Fluorescence-dxf/Gen-AI-Powered-Monitoring-System/Capstone/Dokumentasi/Team1.png

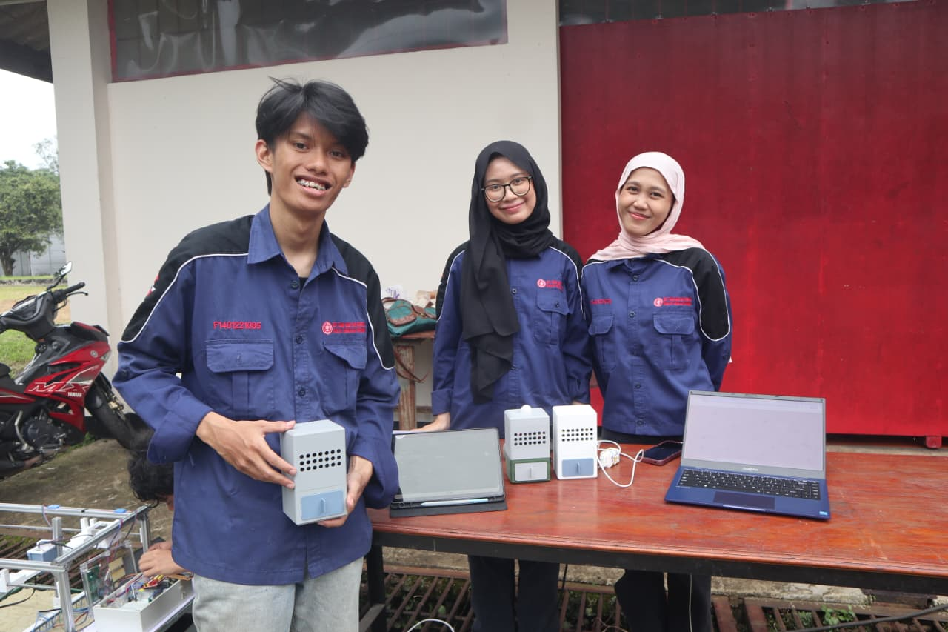
Capstone/Dokumentasi/Team1.png
