Fluorescence-dxf/Gen-AI-Powered-Monitoring-System/Capstone/Dokumentasi/Team.png

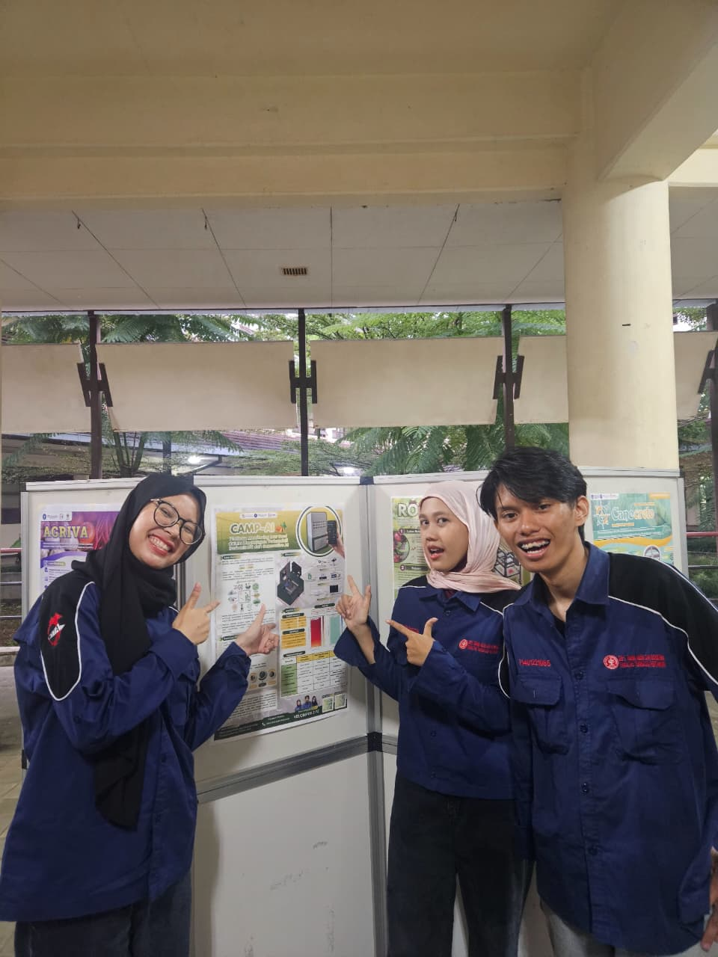
Capstone/Dokumentasi/Team.png
