Fluorescence-dxf/Gen-AI-Powered-Monitoring-System/Capstone/Desain/Bagian Bawah_Capstone.stl

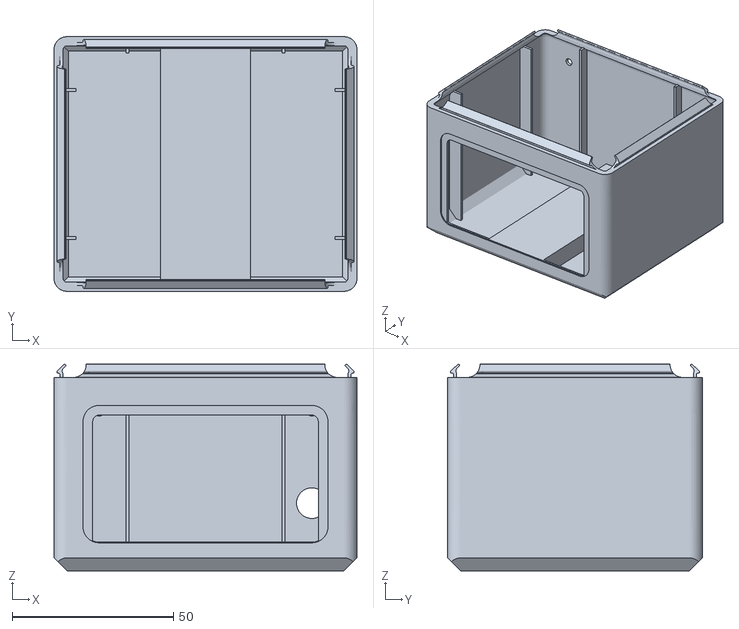
[picture p23: CAD file, 2026-11-03]
Capstone/Desain/Bagian Bawah_Capstone.stl
94.0 x 79.0 x 64.1
