Fluorescence-dxf/Gen-AI-Powered-Monitoring-System/Capstone/Desain/Laci_Capstone.stl

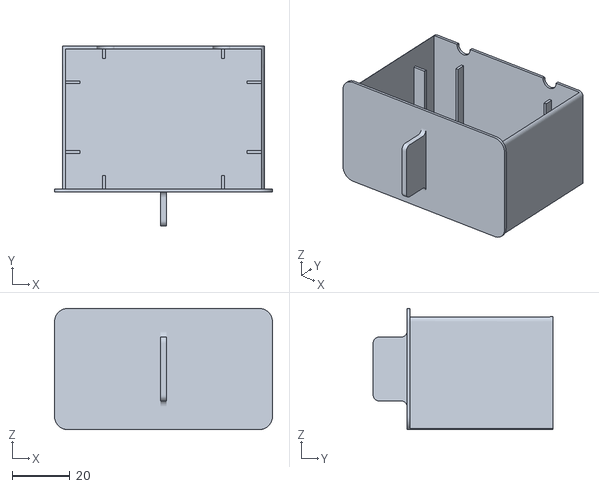
[picture p24: CAD file, 2026-11-03]
Capstone/Desain/Laci_Capstone.stl
75.2 x 62.0 x 41.8
