Fluorescence-dxf/Gen-AI-Powered-Monitoring-System/Capstone/Desain/Bagian Atas_Capstone.stl

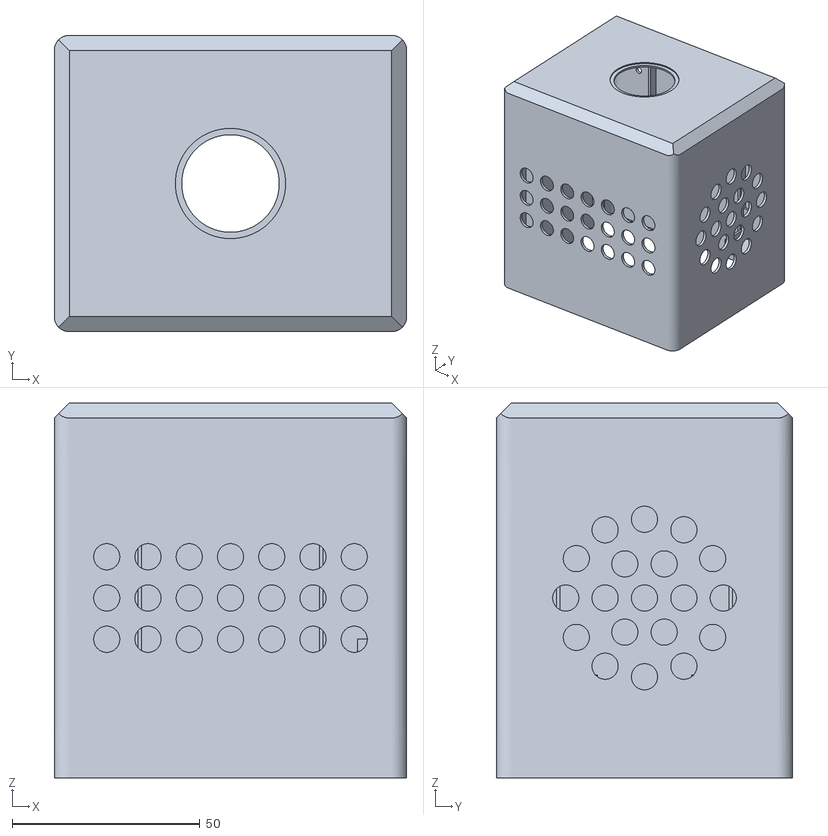
[picture p25: CAD file, 2026-11-03]
Capstone/Desain/Bagian Atas_Capstone.stl
94.0 x 79.0 x 100.0
