Fluorescence-dxf/Gen-AI-Powered-Monitoring-System/Capstone/Dokumentasi/Poster K2P2.pdf

# Platform Monitoring Low Cost dalam Lingkungan Terkendali

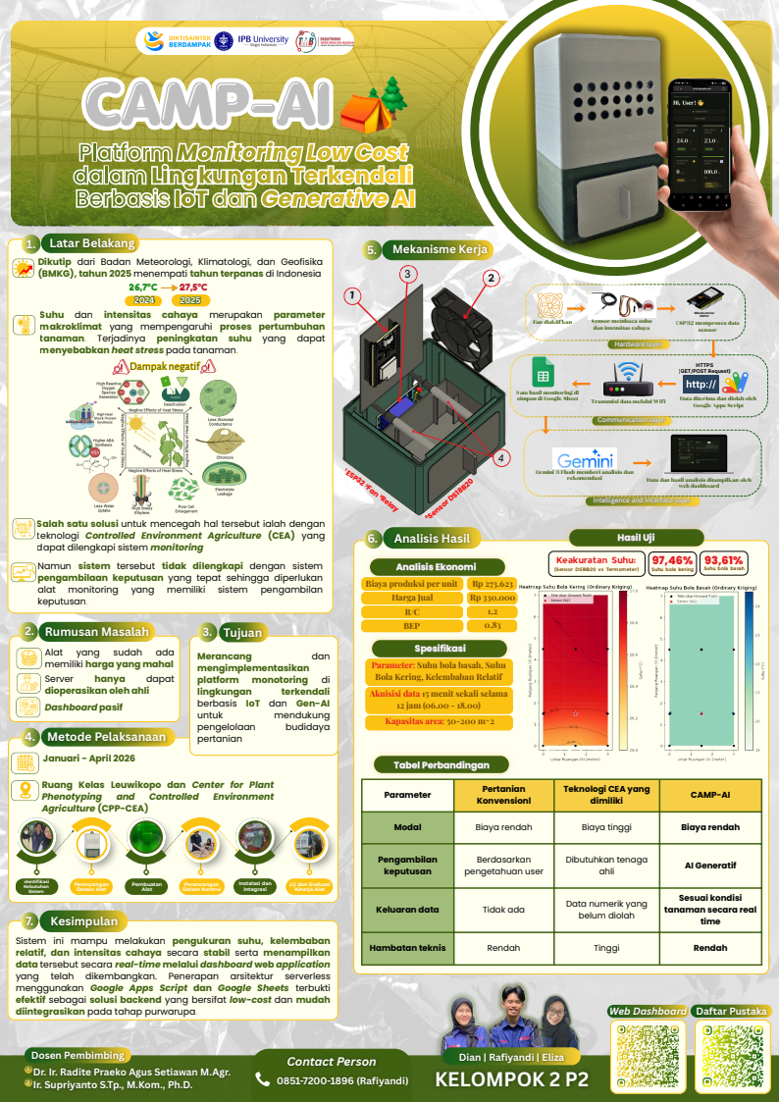
[picture p26: page 1]
CCAAMMPP--AAII; Server; hanya; dapat; Fan diaktifkan; ESP32 memproses data; rekomendasi; web dashboard; HHaarrddwwaarree llaayyeerr; CCoommmmuunniiccaattiioonn llaayyeerr; 6. Analisis Hasil; 0851-7200-1896 (Ra 1896 (Rafiyandi); KELOMPOK 2 P2; Contact Person; Januari - April 2026; 4. Metode Pelaksanaan; Perancangan Desain Alat; Pembuatan Alat; Perancangan Sistem Kontrol; Instalasi dan Integrasi; ¹ ESP32 ²Fan ³Relay; ⁴Sensor DS18B20; 5. Mekanisme Kerja; Daftar Pustaka; HHaassiill UUjjii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

Platform Monitoring Low Cost
dalam Lingkungan Terkendali
Berbasis IoT dan Generative AI

Berbasis IoT dan Generative AI

Latar BelakangDDaammppaakk nneeggaattiiff
Dikutip dari Badan Meteorologi, Klimatologi, dan Geofisika
(BMKG), tahun 2025 menempati tahun terpanas di Indonesia

Suhu dan intensitas cahaya merupakan parameter
makroklimat yang mempengaruhi proses pertumbuhan
tanaman. Terjadinya peningkatan suhu yang dapat
menyebabkan heat stress pada tanaman.

Mikrokontroler
ESP32 Data diterima dan diolah oleh
sensor

Sensor membaca suhu
dan intensitas cahaya

HTTPS
(GET/POST Request)

Data hasil monitoring di
simpan di Google Sheet

Transmisi data melalui Wifi

Google Apps Script

Gemini 3 Flash memberi analisis dan

Data dan hasil analisis ditampilkan oleh

Intelligence and Interface layer

Salah satu solusi untuk mencegah hal tersebut ialah dengan
teknologi Controlled Environment Agriculture (CEA) yang
dapat dilengkapi sistem monitoring
Namun sistem tersebut tidak dilengkapi dengan sistem
pengambilaan keputusan yang tepat sehingga diperlukan
alat monitoring yang memiliki sistem pengambilan
keputusan.

Analisis Ekonomi
Biaya produksi per unit
Harga Jual
BEP
SSppeessiiffiikkaassii

(Sensor DS18B20 vs Termometer)

Rumusan Masalah
Alat yang sudah ada
memiliki harga yang mahal
dioperasikan oleh ahli
Dashboard pasif

3. Tujuan
mengimplementasikan
platform monotoring di
berbasis IoT dan Gen-AI
pertanian

Parameter: Suhu bola basah, Suhu
Bola Kering, Kelembaban Relatif
Akuisisi data 15 menit sekali selama
12 jam (06.00 - 18.00)
Kapasitas area: 50-200 m^2

Ruang Kelas Leuwikopo dan Center for Plant
Phenotyping and Controlled Environment
Agriculture (CPP-CEA)

Parameter | Pertanian Konvensionl | Teknologi CEA yang dimiliki | CAMP-AI

Modal | Biaya rendah | Biaya tinggi | Biaya rendah

Pengambilan keputusan | Berdasarkan pengetahuan user | Dibutuhkan tenaga ahli | AI Generatif

Identifikasi
Kebutuhan
Sistem
7. Kesimpulan
Sistem ini mampu melakukan pengukuran suhu, kelembaban
relatif, dan intensitas cahaya secara stabil serta menampilkan
data tersebut secara real-time melalui dashboard web application
yang telah dikembangkan. Penerapan arsitektur serverless
menggunakan Google Apps Script dan Google Sheets terbukti
efektif sebagai solusi backend yang bersifat low-cost dan mudah
diintegrasikan pada tahap purwarupa.

Uji dan Evaluasi
Kinerja Alat

Keluaran data | Tidak ada | Data numerik yang belum diolah | Sesuai kondisi tanaman secara real time

Hambatan teknis | Rendah | Tinggi | Rendah

Dosen Pembimbing
Dr. Ir. Radit . Radite Praeko Agus Setia o Agus Setiawan M.Agr.
Ir. Supriy . Supriyanto S.Tp., M.Kom., Ph.D om., Ph.D.

Dian | Rafiyandi | Eliza
