Fluorescence-dxf/Gen-AI-Powered-Monitoring-System/(commit log)

2026-11-03 🚀 Initial commit – CAMP-AI complete project with docs, CI, and templates
    [Bagian Atas_Capstone.stl, Bagian Bawah_Capstone.stl, Laci_Capstone.stl]
2026-11-10 feat: enable dynamic multi-module scaling (1 to N nodes), auto-sensor detection, and anti-collision ingestion
    [Capstone.ino]
2026-11-14 fix(backend,docs): prevent single-module row overwrite in horizontal aggregation and update Gemini 2.5 Flash docs
    [Capstone.ino]
