Fluorescence-dxf/Gen-AI-Powered-Monitoring-System/(notices)

Notices in the files:
Capstone/README.md:
License: MIT
